markgwharry/planter/hardware/c6-carrier-rev-a/README.md

# Planter XIAO ESP32-C6 carrier - Rev A

## Perfboard P1 reconciliation - 2026-09-09

The native schematic is now annotated as A-P1 against the 50 x 70mm
A-R / 01-24 perfboard guide. Electrical wiring and component values are
unchanged: the guide connectivity and exported KiCad connectivity agree.
This is a guide-matched circuit, not a physical inspection of every solder joint
or fitted component tolerance. Through-hole perfboard parts implement the same
circuit; assigned SMD footprints are provisional for a future carrier.

The schematic now labels the perfboard sensor/display terminals, JP1 and
PACK+/GND measurement pads. The user's bench observations confirm WeAct 1.54-inch
B&W refresh, air/water endpoints, and battery-only voltage agreement
(screen 3.81V; meter 3.83V). Sleep current remains unmeasured; charging,
protection specifications and outdoor endurance are not verified.

Open `planter-c6-rev-a.kicad_pro`, then the schematic editor.
PCB layout and final module/connector footprints remain outside this revision.

Status: native KiCad 10 schematic captured and checked (2026-09-05).
ERC: zero errors/warnings. Exported connectivity: all 64 terminals match the
reviewed checklist. PCB layout/DRC and physical verification remain outstanding.
See `review.md` for corrections and remaining physical decisions.

This carrier replaces Dupont wiring while retaining the XIAO as the radio,
charger, regulator and processor module. It does not reproduce the XIAO's USB,
charger or RF circuitry.

## Electrical architecture

```text
Protected P+ -> J1.1 -> JP1 -> PACK+ -> XIAO BAT+
                               |
                               +-> R2 200k -> A0 -> R3 200k -> GND
Protected P- -> J1.2 -> GND -> XIAO BAT- and GND

XIAO 3V3 -> Q1 AO3401A -> 3V3_SW -> moisture sensor + e-paper module
```

The protection board must be a common-port 1S design: both charge and load use
P+/P-. B- must never be joined to carrier ground because that bypasses the
protection switch. A pack that already contains protection must not receive a
second protection PCB.

The XIAO's own USB-C remains the only charger. Charging-cover access is an
enclosure requirement but is deliberately outside this electrical revision.

### Protection decision for this prototype

Use one of Mark's existing small B+/B-/P+/P- protection boards, off the carrier,
secured and insulated with the cell. This uses the parts already available and
keeps protection attached when the battery assembly is unplugged. Do not add a
second protection circuit to this revision of the carrier. A later integrated
version needs a selected protection IC/FET pair, thresholds, leakage budget and
a separately reviewed layout; it is not just a footprint substitution.

The four pad labels alone do not establish the board's ratings, cutoffs or
common-port charging behaviour. Before assembly, obtain clear photos of both
sides and chip markings, identify the part/supplier, and confirm compatibility
with the exact 1S cell and the XIAO charger. Prior successful installs are useful
experience, not verification of those specifications. Use an insulated mount
and strain relief, not loose bare boards or Duponts on the battery circuit.

Charge indoors, dry, and within the cell manufacturer's temperature limits.
Do not assume the inexpensive protection board provides temperature monitoring.
Do not test overcharge or short-circuit cutoff by abusing a real cell; any such
characterisation needs an appropriate current-limited bench setup.

## Fixed pin map

| XIAO label | ESP32-C6 GPIO | Carrier signal | Direction |
|---|---:|---|---|
| D0 / A0 | 0 | VBAT_ADC | input |
| D1 / A1 | 1 | MOIST_ADC | input |
| D2 / A2 | 2 | PERIPH_EN_N | output, LOW = on |
| D3 | 21 | EPD_CS | output |
| D4 | 22 | EPD_DC | output |
| D5 | 23 | EPD_RST | output |
| D6 | 16 | EPD_BUSY | input |
| D7 | 17 | spare / test pad | - |
| D8 | 19 | EPD_SCLK | output |
| D9 | 20 | spare; MISO unused | - |
| D10 | 18 | EPD_MOSI | output |

The display is write-only. Firmware must initialise SPI with MISO disabled.

## Battery input and measurement

J1 accepts protected P+ and P-. JP1 is a normally-fitted removable link in the
positive lead so complete-device sleep and wake current can be measured without
cutting a trace.

Fit BOTH R2 = 200k from PACK+ (after JP1) to D0/A0 and R3 = 200k from
D0/A0 to GND. Fit C1 = 100nF from A0 to GND at the XIAO. The ADC sees
half the pack voltage (2.1V at 4.2V); divider current is 10.5uA at full charge.

Correction to the initial proposal: Seeed's onboard R10 = 200k connects the
charger IREF pin to ground, setting approximately 120mA charging current.
It does NOT connect to A0. Omitting R3 would expose A0 to excessive voltage.
This was verified visually on sheet 03 Power of the official 2026-01-14
[XIAO schematic](https://files.seeedstudio.com/wiki/SeeedStudio-XIAO-ESP32C6/XIAO_ESP32_C6_v1.0_SCH_260114.pdf).

## Switched peripheral rail

Q1 is an AO3401A P-channel MOSFET:

- source: XIAO 3V3;
- drain: 3V3_SW;
- gate: R4 1k from D2;
- R1 100k from gate to 3V3, holding the rail off during reset and sleep.

AO3401A SOT-23 pad mapping: 1 = gate, 2 = source, 3 = drain.

C2 = 10uF and C3 = 100nF decouple 3V3_SW beside the display connector. The
sensor and display are powered only while awake. Before Q1 is switched off,
firmware drives CS, DC, RST, SCLK and MOSI LOW and gives BUSY a pull-down so an
unpowered module cannot be back-powered through its signal pins.

ESP32-C6 retains each selected pad with `gpio_hold_en()` directly during deep
sleep. Unlike the S3 build, it must not call the older global
`gpio_deep_sleep_hold_en()` API, which current ESP-IDF does not expose for C6.

## Connectors

### J2 - moisture probe, keyed 3-way

| Pin | Signal |
|---:|---|
| 1 | 3V3_SW |
| 2 | MOIST_OUT |
| 3 | GND |

R5 = 1k sits between MOIST_OUT and D1/A1. C4 = 100nF from D1/A1 to ground is
fitted beside the XIAO. C5 = 100nF decouples J2.1 to GND beside J2.
Sensor cable ESD protection is a pending part-selection decision; no unspecified
diode is included in the capture BOM/netlist.

### J3 - WeAct 1.54-inch module, 2x4 at 2.54mm pitch

The supplied WeAct mechanical drawing defines the module header as:

| Pin | WeAct signal | Carrier connection |
|---:|---|---|
| 1 | BUSY | D6 / GPIO16 |
| 2 | RES | D5 / GPIO23 |
| 3 | D/C | D4 / GPIO22 |
| 4 | CS | D3 / GPIO21 |
| 5 | SCL | D8 / GPIO19 |
| 6 | SDA | D10 / GPIO18 |
| 7 | GND | GND |
| 8 | VCC | 3V3_SW |

Use a shrouded, polarised 2x4 header on the carrier if the display is cabled.
Pin 1 must be marked on copper and silkscreen. The module accepts 3.3-5V power
but its I/O is 3.3V, so this carrier powers it from 3V3_SW.

## Mechanical capture inputs

From the supplied WeAct board-shape PDF:

- overall module envelope: 50.12 x 32.60mm;
- mounting-hole centres: 44.52 x 27.00mm;
- four mounting holes: 3.00mm diameter;
- hole radius: 1.50mm (the drawing's R1.5 annotation points to a hole);
- 2x4 signal header: 2.54mm pitch, on the left-hand side when viewed from the
  component face.

Use the supplied STEP model for enclosure clearance and connector orientation.

## Layout requirements

- Use Seeed's official XIAO ESP32-C6 footprint and antenna keepout.
- No copper, battery, display backplane or metal fastener beneath/in front of
  the XIAO antenna end.
- Resolve the XIAO underside BAT contact method before layout: the pads cannot
  be assumed coplanar with the castellations. Verify the official footprint and
  underside component clearance. Short strain-relieved soldered battery leads
  are the practical hand-assembly baseline; direct reflow needs a verified stack.
- Keep USB-C, BOOT and RESET reachable with the enclosure cover removed.
- Put J1 and J2 on the downward/cable side; put J3 toward the display cavity.
- Add labelled test points: PACK+, GND, 3V3, 3V3_SW, VBAT_ADC, MOIST_ADC,
  PERIPH_EN_N, EPD_BUSY, D7 and D9.
- Mark board name, `REV A`, connector polarity and pin 1 on both copper and
  silkscreen where practical.

## First-article gates

Do not call the board field-ready until all of these pass:

1. Confirm the protection PCB's exact B+/B-/P+/P- arrangement before connection.
2. With USB removed, A0 measures half of P+ to P- within resistor tolerance.
3. Calibrated firmware battery voltage agrees with a DMM within 50mV.
4. USB-C charges through the protection board without abnormal heating.
5. Sensor and display operate from 3V3_SW and fully lose power when it is off.
6. No signal pin remains high while 3V3_SW is off.
7. Measure whole-assembly deep-sleep current at JP1; investigate any result in
   the hundreds of microamps before outdoor deployment.
8. Recalibrate dry and wet moisture endpoints on the assembled carrier.
9. Run a 24-hour bench soak including repeated Wi-Fi and display updates.
10. Complete enclosure gasket, display-window and charging-access tests.

## Files

- `planter-c6-rev-a.kicad_pro`: open this project in KiCad 10.
- `planter-c6-rev-a.kicad_sch`: authoritative editable schematic, one A3 sheet.
- `Planter.kicad_sym` and `sym-lib-table`: self-contained project symbols.
- `planter-c6-rev-a.svg`: preview exported directly from the native schematic.
- `erc.rpt`: KiCad 10.0.5 electrical-rule report, no exclusions added.
- `check_kicad.py`: validates actual exported KiCad connectivity and values.
- `make_kicad.py`: reproducible capture baseline; do not rerun over GUI edits.
- `LIBRARY-LICENSE.md`: attribution for the standard KiCad symbol extracts.
- `bom.csv`: fitted electrical BOM, with exact connector selection pending.
- `carrier-schematic.svg`: earlier component-level overview, not the native source.
- `review.md`: review findings, evidence and outstanding fabrication work.
- `netlist.csv`: connection-level capture checklist for KiCad.
- `check_capture.py`: terminal coverage and circuit-invariant checks.
- `draw_schematic.py`: reproducible SVG generator.
- `weact-module-mechanics.md`: source dimensions and orientation notes.
- `../../../platformio-c6.ini`: C6 firmware build configuration.

The XIAO symbol uses physical edge contact numbers 1-14 plus semantic underside
contacts `BAT+` and `BAT-`. It is deliberately application-specific, including
GPIO electrical directions. Its PCB footprint is NOT assigned: the eventual
carrier must implement the underside wire lands separately or map to a verified
module/contact footprint. J1, J2 and J3 likewise remain unassigned until the exact
connectors and display cable are confirmed. All passives, Q1, JP1 and test points
have nominal standard footprints, still subject to layout/assembly review.

To repeat schematic validation without changing the capture:

```sh
python3 hardware/c6-carrier-rev-a/check_capture.py
python3 hardware/c6-carrier-rev-a/check_kicad.py
kicad-cli sch erc hardware/c6-carrier-rev-a/planter-c6-rev-a.kicad_sch \
  --severity-all --exit-code-violations -o /tmp/planter-erc.rpt
```

`check_kicad.py` finds KiCad on PATH or at its standard macOS installation;
`KICAD_CLI` can override that path. A clean ERC is schematic connectivity
evidence, not proof of protection-board behaviour or PCB fabrication readiness.

Build the shared v2 firmware for this carrier with:

```sh
pio run --project-conf platformio-c6.ini -e esp32c6_rev_a
```

The C6 build intentionally pins pioarduino platform 55.03.311 (Arduino-ESP32
3.3.11) rather than following its moving `stable` URL. The official PlatformIO
Espressif platform currently declares the XIAO ESP32-C6 as ESP-IDF-only even
though Arduino-ESP32 itself supports the C6.

The original S3 v2 proposal remains buildable from the same source using
`platformio-s3-v2.ini`; this prevents the C6 pin map from silently replacing the
existing design.
