markgwharry/planter/hardware/carrier-rev-b/netlist.csv

Net | From | To | Notes
PACK_IN+ | J1.1 | JP1.1 | Protected P+ only
PACK+ | JP1.2 | U1.BAT+ | XIAO underside BAT+ pad: plated hole on the carrier
PACK+ | JP1.2 | R2.1 | Battery divider top
PACK+ | JP1.2 | TP1
GND | J1.2 | U1.GND | Protected P- only; battery return via the GND castellation (the XIAO BAT- pad is the same GND)
VBAT_ADC | R2.2 | U1.D3 | S3 GPIO4 (ADC1_CH3)
VBAT_ADC | R2.2 | C1.1 | 100nF filter
VBAT_ADC | R2.2 | R3.1 | Mandatory fitted bottom resistor
GND | C1.2 | GND
GND | R3.2 | GND
3V3 | U1.3V3 | Q1.S | Always-on regulated rail
3V3 | U1.3V3 | R1.1 | 100k pull-up upper terminal
GATE | R1.2 | Q1.G | 100k pull-up lower terminal
PERIPH_EN_N | U1.D1 | R4.1 | S3 GPIO2; active low
GATE | R4.2 | Q1.G | 1k gate resistor
3V3_SW | Q1.D | J2.1 | Moisture power
3V3_SW | Q1.D | J3.8 | E-paper VCC
3V3_SW | Q1.D | C2.1 | 10uF near J3
3V3_SW | Q1.D | C3.1 | 100nF near J3
3V3_SW | Q1.D | TP3
GND | C2.2 | GND
GND | C3.2 | GND
MOIST_OUT | J2.2 | R5.1 | Probe analogue output
MOIST_ADC | R5.2 | U1.D2 | S3 GPIO3 (ADC1_CH2)
MOIST_ADC | R5.2 | C4.1 | 100nF filter
GND | C4.2 | GND
GND | J2.3 | GND
3V3_SW | J2.1 | C5.1 | 100nF near sensor connector
GND | C5.2 | GND
EPD_BUSY | J3.1 | U1.D4 | S3 GPIO5: input from reset
EPD_RST | J3.2 | U1.D5 | S3 GPIO6
EPD_DC | J3.3 | U1.D7 | S3 GPIO44 (UART0 RX): input from reset
EPD_CS | J3.4 | U1.D8 | S3 GPIO7
EPD_SCLK | J3.5 | U1.D9 | S3 GPIO8; SPI pins are set in firmware
EPD_MOSI | J3.6 | U1.D10 | S3 GPIO9
GND | J3.7 | GND
GND | TP2 | GND
NC_D0 | U1.D0 | NC | S3 GPIO1; spare
NC_D6 | U1.D6 | NC | UART0 TX: ROM boot log; deliberately unused
NC_VBUS | U1.VBUS | NC | Intentionally unconnected carrier pad
