markgwharry/planter/hardware/carrier-rev-b/planter-carrier-rev-b.kicad_pcb

## KiCad design hardware/carrier-rev-b/planter-carrier-rev-b.kicad_pcb (2026-10-24)

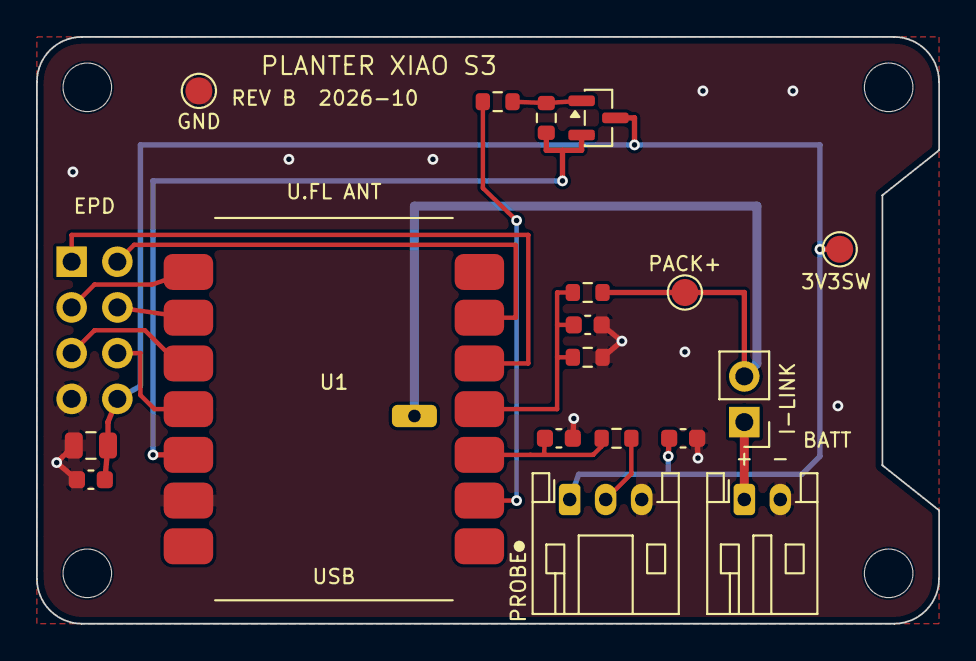
[picture p3: board planter-carrier-rev-b.kicad_pcb from above]

Board: 2 copper layers, 50.1 x 32.6 mm, 23 parts (1 on the bottom side), 16 nets.

Parts:
C1, C3, C4, C5: 100nF; C_0603_1608Metric
C2: 10uF; C_0805_2012Metric
H1, H2, H3, H4: M2.5; MountingHole_2.7mm_M2.5
J1: PROTECTED BATTERY; JST_PH_S2B-PH-K_1x02_P2.00mm_Horizontal
J2: MOISTURE PROBE; JST_PH_S3B-PH-K_1x03_P2.00mm_Horizontal
J3: WEACT 1.54 INCH; PinSocket_2x04_P2.54mm_Vertical
JP1: CURRENT LINK; PinHeader_1x02_P2.54mm_Vertical
Q1: AO3401A; SOT-23
R1: 100k 1%; R_0603_1608Metric
R2, R3: 200k 1%; R_0603_1608Metric
R4, R5: 1k; R_0603_1608Metric
TP1: TP1; TestPoint_Pad_D1.5mm
TP2: TP2; TestPoint_Pad_D1.5mm
TP3: TP3; TestPoint_Pad_D1.5mm
U1: Seeed XIAO ESP32-S3; Seeed_XIAO_ESP32S3_SMD

Connections:
/3V3: Q1.2, R1.1, U1.12
/3V3_SW: C2.1, C3.1, C5.1, J2.1, J3.8, Q1.3, TP3.1
/EPD_BUSY: J3.1, U1.5
/EPD_CS: J3.4, U1.9
/EPD_DC: J3.3, U1.8
/EPD_MOSI: J3.6, U1.11
/EPD_RST: J3.2, U1.6
/EPD_SCLK: J3.5, U1.10
/GATE: Q1.1, R1.2, R4.2
/GND: C1.2, C2.2, C3.2, C4.2, C5.2, J1.2, J2.3, J3.7, R3.2, TP2.1, U1.13
/MOIST_ADC: C4.1, R5.2, U1.3
/MOIST_OUT: J2.2, R5.1
/PACK+: JP1.2, R2.1, TP1.1, U1.23
/PACK_IN+: J1.1, JP1.1
/PERIPH_EN_N: R4.1, U1.2
/VBAT_ADC: C1.1, R2.2, R3.1, U1.4
