markgwharry/planter/(commit log)

2026-03-16 Add ESP32-C3 soil moisture monitor with e-ink display
    PlatformIO project for ESP32-C3 SuperMini with WeAct 2.13" tri-color
    e-ink display and capacitive soil moisture sensor. Shows moisture
    percentage, status label, plant graphic, and progress bar. Uses deep
    sleep for battery efficiency.
2026-03-16 Calibrate moisture sensor and enable deep sleep
    Calibrated ADC range from actual sensor readings (3825 dry, 2358 wet).
    Switched to tri-color display driver (GxEPD2_213_Z98c) and disabled
    BUSY pin (GPIO 9 conflicts with boot button). Debug mode off.
2026-04-01 Port to Seeed XIAO ESP32-S3 with Waveshare 1.54" B/W display
    Switch from ESP32-C3 SuperMini + WeAct 2.13" tri-colour to XIAO ESP32-S3
    + Waveshare 1.54" B/W (SSD1681, 200x200). Remap pins to S3 hardware SPI,
    enable BUSY pin, and rework layout for square panel.
    [main.cpp]
2026-04-07 Add MQTT moisture alerts via WiFi to existing Mosquitto broker
    Publishes to planter/alert when moisture is below 20% or above 90%,
    with a daily heartbeat on planter/moisture. WiFi credentials kept in
    gitignored secrets.h. Uses RTC memory to track wake count across
    deep sleep cycles.
    [main.cpp]
2026-04-07 Add per-plant MQTT topics and TIG stack for multi-sensor monitoring
    MQTT topics now use planter/<plant_id>/moisture and planter/<plant_id>/alert,
    with PLANT_ID configured per-device in secrets.h. Includes Docker Compose
    for Telegraf + InfluxDB + Grafana with wildcard MQTT subscription,
    auto-provisioned datasource, and a starter dashboard with time series,
    gauges, and alert table.
2026-06-19 Recalibrate moisture sensor for 1S LiPo; add battery-monitor hardware spec
    Recalibrate against battery-backed 3.3V rail: dry 3825->3160, wet
    2358->1300 (was reading 45% when bone dry). Add ESP32-S3 native-USB-CDC
    monitor flags (monitor_dtr/rts) so the serial monitor opens without
    strapping the chip into the bootloader, and fix the upload/monitor port.
    Document the planned 1S LiPo battery-voltage divider (NEW_HARDWARE.md):
    220k/220k tap on D9/GPIO8, firmware hooks, trim procedure, and the
    low-battery threshold that bounds when the moisture calibration is valid.
    [main.cpp]
2026-06-19 Add 1S LiPo battery monitoring (voltage, MQTT, low-batt alert, e-ink)
    readBatteryVolts() reads a resistive divider on BATT_PIN (default
    D9/GPIO8, the only free ADC pin on this board) via analogReadMilliVolts
    for eFuse-calibrated readings; discards first sample and averages 16 so
    no tap capacitor is required. Battery voltage and a batt_low flag are
    added to the MQTT payload, low battery joins the alert path, and the
    voltage shows top-left on the e-ink.
    Validity guard: readings below BATT_VALID (2.50 V) are treated as an
    unwired/floating sense pin — no alert, display shows "BAT --" — so this
    is safe to flash before the divider wiring is confirmed. Pin and ratio
    are single-line settings; r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
2026-08-03 Fix moisture sensor VCC in WIRING.md: switched D5, not 3V3
    The wiring table predated the switched-power change in the firmware and
    still showed the sensor's VCC tied to the 3V3 rail. main.cpp defines
    SENSOR_PWR as GPIO6 (D5) and readMoisturePercent() toggles it around the
    ADC sample burst, so a permanent 3V3 tie leaves the probe powered 24/7 and
    makes the digitalWrite calls a no-op.
    Also record the cable colours and note why 5V is not an option (no 5V rail
    off USB, ratiometric output vs fixed ADC reference, 3.6 V pin maximum).
    Claude-Session: https://claude.ai/code/session_01HQ4pFqhCLf2qTQknjFcdXu
2026-08-03 Align NEW_HARDWARE.md with switched sensor supply
    The battery-monitor rationale still described the moisture sensor as fed
    directly from the 3V3 rail, contradicting the wiring table. The sensor is
    fed from D5/GPIO6, switched high only for a read.
    The dropout argument is unaffected: a GPIO high level follows the 3V3 rail,
    so LDO dropout still drags the sensor's supply — and its ratiometric output
    — down with it. Say so explicitly rather than implying the switch decouples
    the two.
    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
2026-08-04 Switch to B/W panel as standing config; document physical wiring map
    The tri-colour B/W/R module was a stopgap after a panel was lost to ribbon
    damage. The build is back on B/W parts (GDEH0154D67, SSD1681) and we stock
    spares, so B/W is now the default rather than the fallback.
    Firmware:
    - Default PANEL 0 in src/main.cpp and firmware-v2/planter_v2.cpp; the
    tri-colour options stay for compatibility only.
    - Drop the redundant -DPANEL=0 override from platformio.ini so the source
    define is the single source of truth.
    power-design.md §8 reworked, since the budget was built on the 14 s
    tri-colour refresh:
    - Panel cost 1 -> ~0.2 mAh/day; total 2.3 -> ~1.4 mAh/day; runtime ~5 -> ~9
    months o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
    [main.cpp, planter_v2.cpp]
2026-09-04 Add ESP32-C6 carrier Rev A design
    [bom.csv, netlist.csv]
2026-09-05 Correct C6 battery divider and review carrier circuit completeness
    [bom.csv, netlist.csv]
2026-09-05 Capture C6 carrier in KiCad with external battery protection
    [planter-c6-rev-a.kicad_sch]
2026-10-24 Calibrate C6 perfboard moisture endpoints (2661/1185)
    Air/water calibration from ten readings per endpoint on the assembled
    XIAO ESP32-C6 perfboard, applied only under PLANTER_XIAO_C6. Legacy S3
    values unchanged.
2026-10-24 Reconcile C6 schematic with perfboard P1 (rev A-P1)
    Annotate perfboard terminals, JP1 and PACK+/GND test pads; record bench
    battery check. Connectivity unchanged; ERC clean. SVG re-exported.
2026-10-24 Keep brownout conservation latched for the whole brownout boot
    A sagged cell recovers open-circuit within seconds, so the VBAT read after a
    brownout reset could clear the latch; with wakeCount reset to 0 the heartbeat
    was then due and WiFi came straight back up, recreating the brownout loop.
    Voltage recovery now waits for the next conservation wake.
2026-10-24 Add Rev B carrier PCB for socketed XIAO C6 or S3
    Rev A's circuit as a 2-layer board on the WeAct 1.54" outline and M2.5
    hole pattern, mounted behind the module with J3 on the underside. The XIAO
    is socketed and every connection uses its pad labels, so the same board
    takes a C6 or an S3.
    - BUSY moved from D6 (UART0 TX on both chips) to D7 (RX).
    - Battery reaches the XIAO's underside BAT pads through J4 wire pads.
    - Copper keep-out under the XIAO antenna end.
    - make_kicad.py builds the schematic from netlist.csv; make_pcb.py builds
    the board from the exported schematic netlist, so parity holds.
    - check.sh: ERC, DRC and schematic parity all clean. make_fab.sh writes
    the Gerbers, BOM and CP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
2026-10-24 Rev B carrier: freeze on XIAO ESP32-S3, soldered flat
    The socketed C6-or-S3 layout left the XIAO's underside BAT pads to a
    flying lead that had to leave the socket tunnel and loop back to J4, and
    the module could only sit on headers above the passives. With one chip
    the board can use its exact land pattern instead.
    - U1 is Seeed's XIAO-ESP32-S3-SMD land pattern, rotated so USB-C stays
    at the bottom edge. The underside BAT+/BAT- pads land on plated pads
    (solder from the back, or reflow); J4 is gone.
    - Nothing sits under the module. The S3 uses a U.FL antenna, so the C6
    antenna keep-out is dropped: the XIAO moves left beside J3 and the
    switch, divider and filters use the freed right s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
2026-10-24 Rev B: drop the BAT- pad; return through the GND castellation
    The XIAO's underside BAT- pad is module GND, the same net as castellation
    13, so a carrier pad under it only added a hidden joint 0.65 mm from BAT+
    that could short the cell, and one that is hard to heat on the planes. It
    now sits on solder mask and the battery returns through the GND
    castellation.
    README: the BAT+ pad is plated through, so a stencil puts no paste on it;
    it is soldered from the back even when the rest is reflowed. Add a
    TP1-to-GND short check and a powered check of the hidden joint.
    Claude-Session: https://claude.ai/code/session_01Y2pFZDRMef9EECGaLGphfU
